tank-uk/buryak-pi-2021/docs/photos/FIX4.jpg

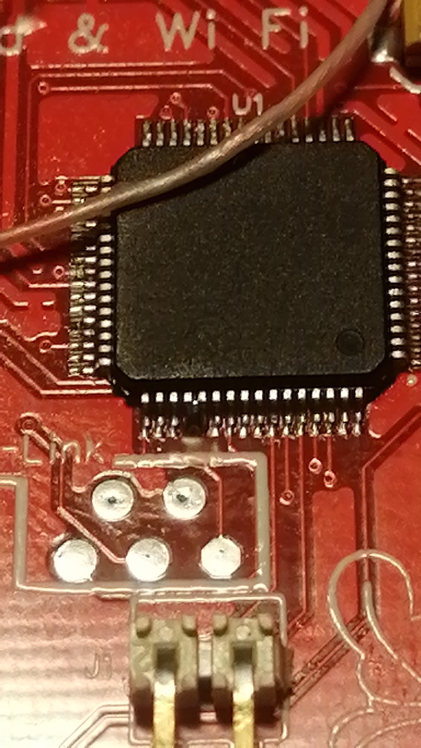
docs/photos/FIX4.jpg
