tank-uk/buryak-pi-2021/docs/photos/FIX3.jpg

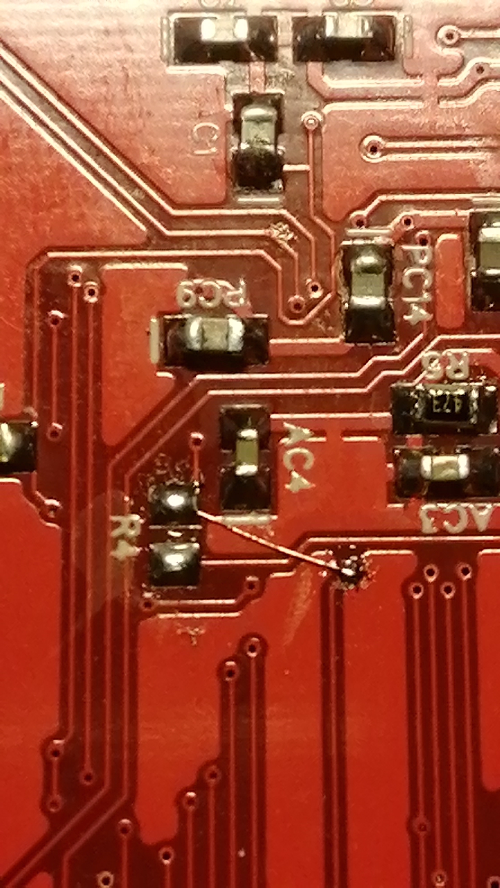
docs/photos/FIX3.jpg
