tank-uk/buryak-pi-2021/README.md

# buryak-pi-2021
FPGA based Buryak

  Центральный Процессор Z80 (Z84C0020FEC)
  
  Основная логика EP4CE6E22C8
  
  Память CY62167ELL(EV30/DV30)
  
  Контроллер Клавиатуры и Джойстика AtMega8a-16
  
  Выход VGA 50Hz
  
  Тайминги Пентагон

  2 турбо режима без вейта 7 и 14 МГц с индикацией светодиодом ( для ТЕСТИРОВАНИЯ Z80 и памяти есть прошивка 21МГЦ , только для тестов , многое не работает из-за рассинхронизации с периферией )
  
Периферия:

  DivMMC , Z-контроллер
  
  Tape IN/OUT
  
  WildSound III (STM32F405) ( AY , TS , XM ) с USB-UART ( CP2102 )
  
  SoundDrive
  
  Wi-Fi на порту AY
  
  Buryak 2021 управление:

F1-F8       - выбор ПЗУ ( индицируется светодиодом ) 0 банк не горит , все остальные - горит

F11         - NMI

F12         - Reset

Scroll Lock - Turbo ( индицируется светодиодом ) 3.5(не горит)/7(горит)/14(мигает)

Pause - пауза ( индицируется светодиодом )

Первая ошибка на плате звука , у микросхемы U7 (мост UART) нет соединения между 7 и 8 ножками
Вторая ошибка у компаратора U10 отсутствует подтяжка к питанию на выходе, нужно между 7 и 8 ножками U10 запаять резистор 1к 0603/0402

В герберах RC1.1 исправлено.

Добавлены герберы под китайский SD холдер
