tank-uk/buryak-pi-2021/docs/flashing.pdf

# Инструкция по прошивке

прошиваем AtMega8 этим :

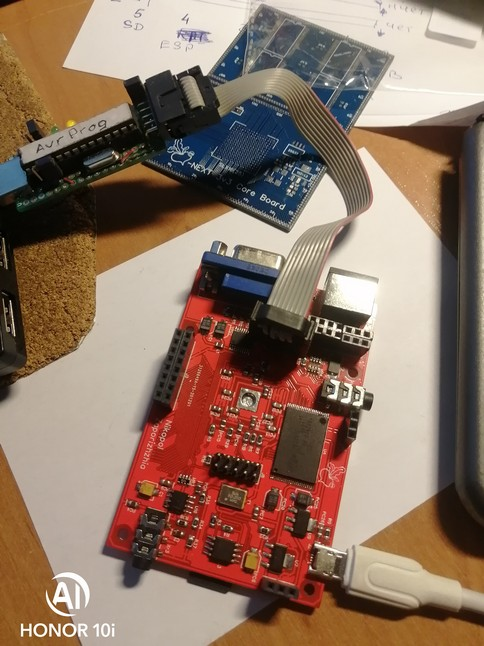
[picture p3: figure]

https://github.com/tank-uk/buryak-pi-2021/blob/main/firmware/release/avr_kbd.hex

### ФЬЮЗЫ : Low 8Eh, High: D9h

прошиваем FPGA ( Flash ) этим :

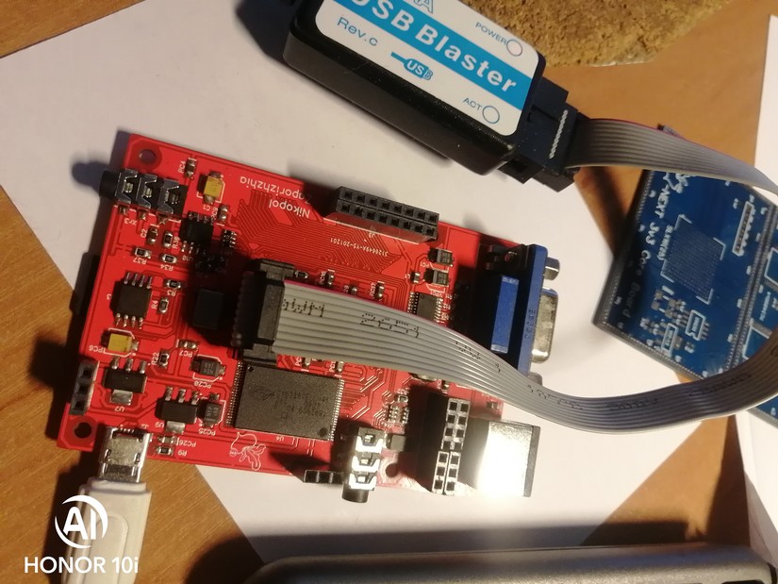
[picture p4: figure]

https://github.com/tank-uk/buryak-pi-2021/blob/main/firmware/release/firmware_speccy.jic

Для прошивки STM :

1. подключаем плату вертолетом

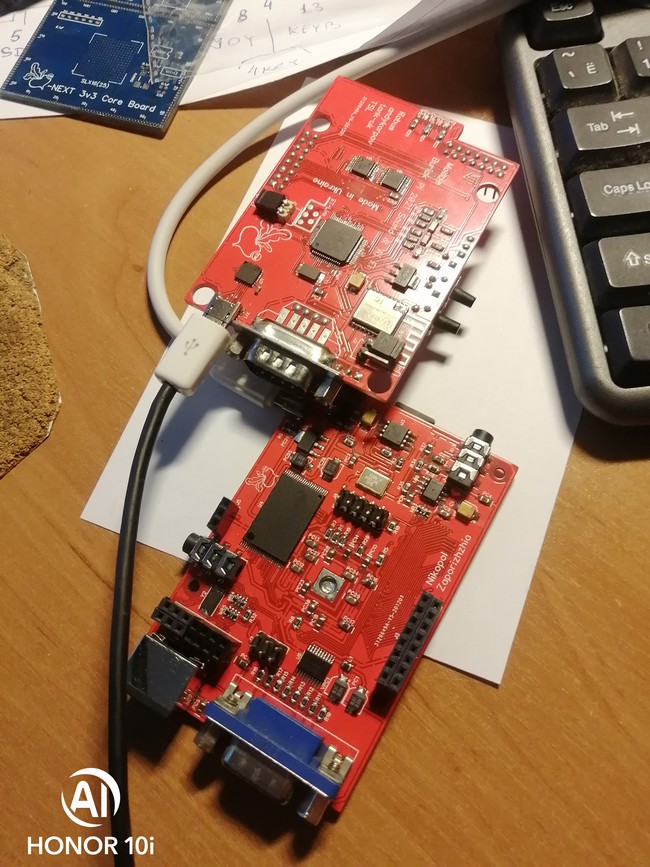
[picture p5: figure]

2. устанавливаем перемычку STM Boot

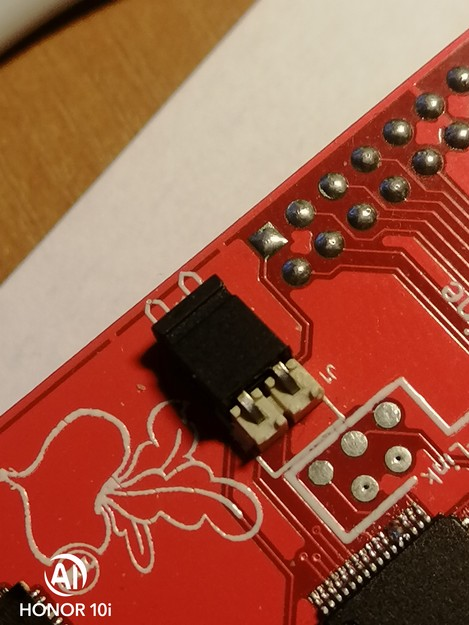
[picture p6: figure]

3. подаем питание на основную плату и вторым кабелем подключаем к ПК
4. проливаем это

https://github.com/tank-uk/buryak-pi-2021/blob/main/firmware/release/STM_AYX32_TSL_WILDSOUND_Final.hex (https://github.com/tank-uk/buryak-pi-2021/blob/main/firmware/release/STM_AYX32_TSL_WILDSOUND_Final.hex)

инструкция и софт по прошивке STM из Windows https://istarik.ru/blog/stm32/111.html

если при прошивке AtMega возникают ошибки:
разрезать перемычку AVR Power возле разьема AVR JTAG
подать питание на AVR от программатора
после прошивки залить перемычку припоем

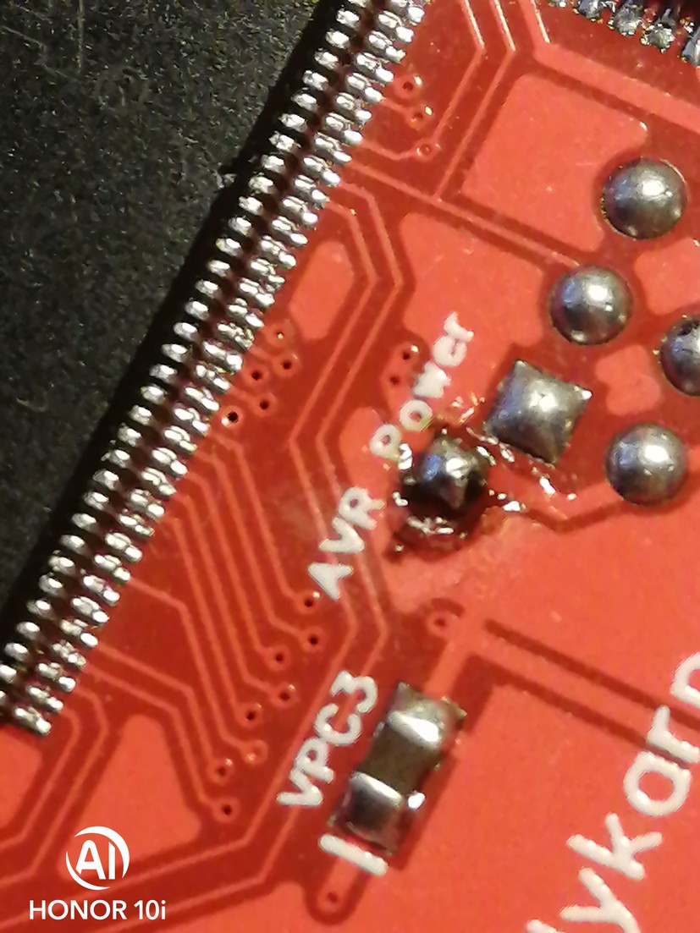
[picture p7: figure]
