tank-uk/buryak-pi-2021/docs/photos/Rev1_Fix1.png

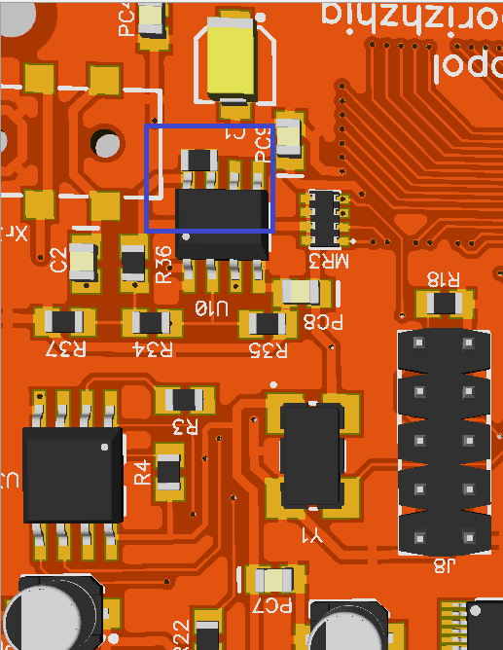
docs/photos/Rev1_Fix1.png
