tank-uk/buryak-pi-2021/docs/photos/Rev1_Fix2.png

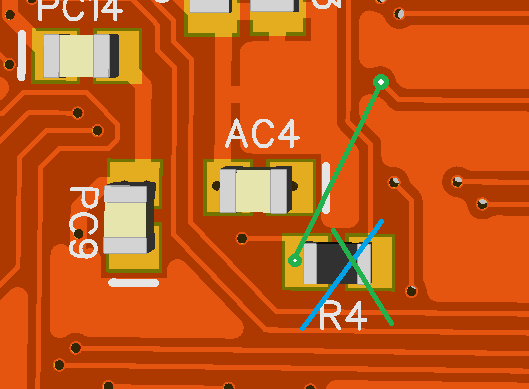
docs/photos/Rev1_Fix2.png
