tank-uk/buryak-pi-2021/docs/photos/Rev1_Fix4.png

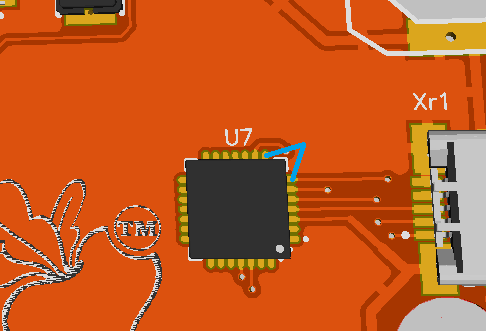
docs/photos/Rev1_Fix4.png
