tank-uk/buryak-pi-2021/(threads)

Thread 5 (2021-09-09):

Синхронизировать старт и начальный ресет от меги

andykarpov, 2021-09-09:
Сейчас мега ждет 2с и потом шлет сигнал сброса при старте.
В некоторых случаях почему-то это все не работает.
Нужно сделать как в карабасе, чтоб начальный сигнал сброса формировался, когда обе стороны готовы (fpga + avr).
