tank-uk/buryak-pi-2021/docs/CPU_Module.pdf

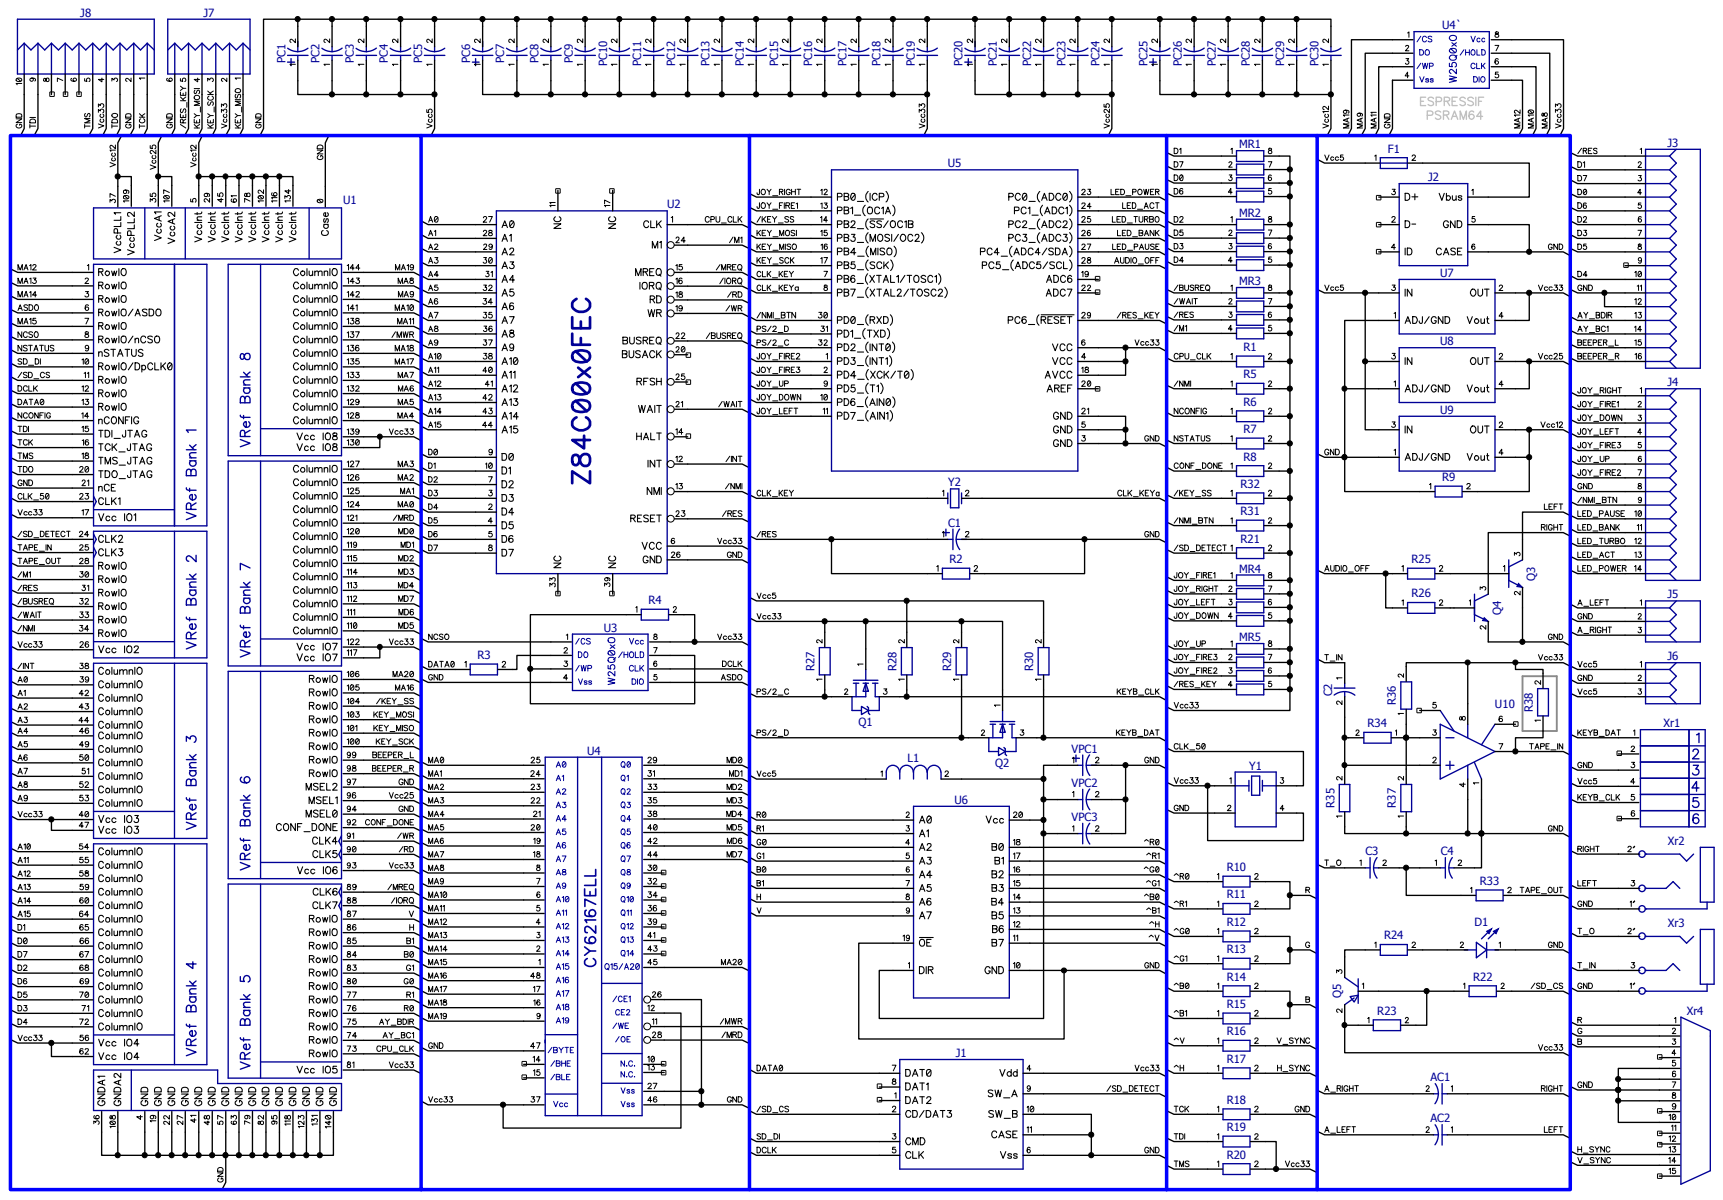
[picture p12: page 1]
