tank-uk/buryak-pi-2021/docs/Sound_WiFi.pdf

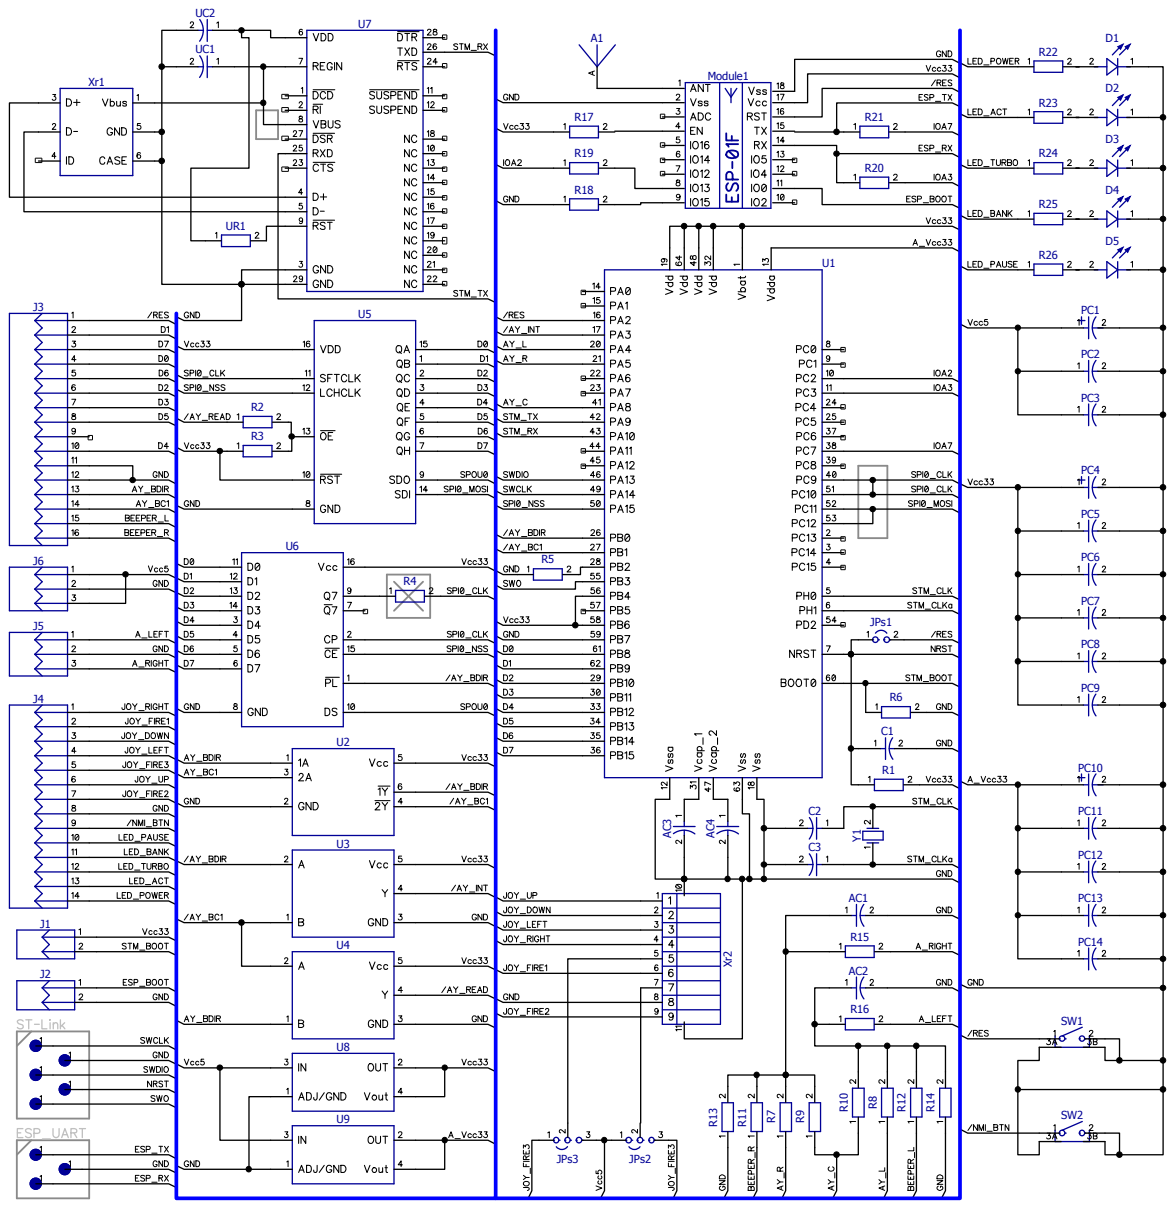
[picture p13: page 1]
