tank-uk/buryak-pi-2021/docs/Sound_WiFi_RC1.1.pdf

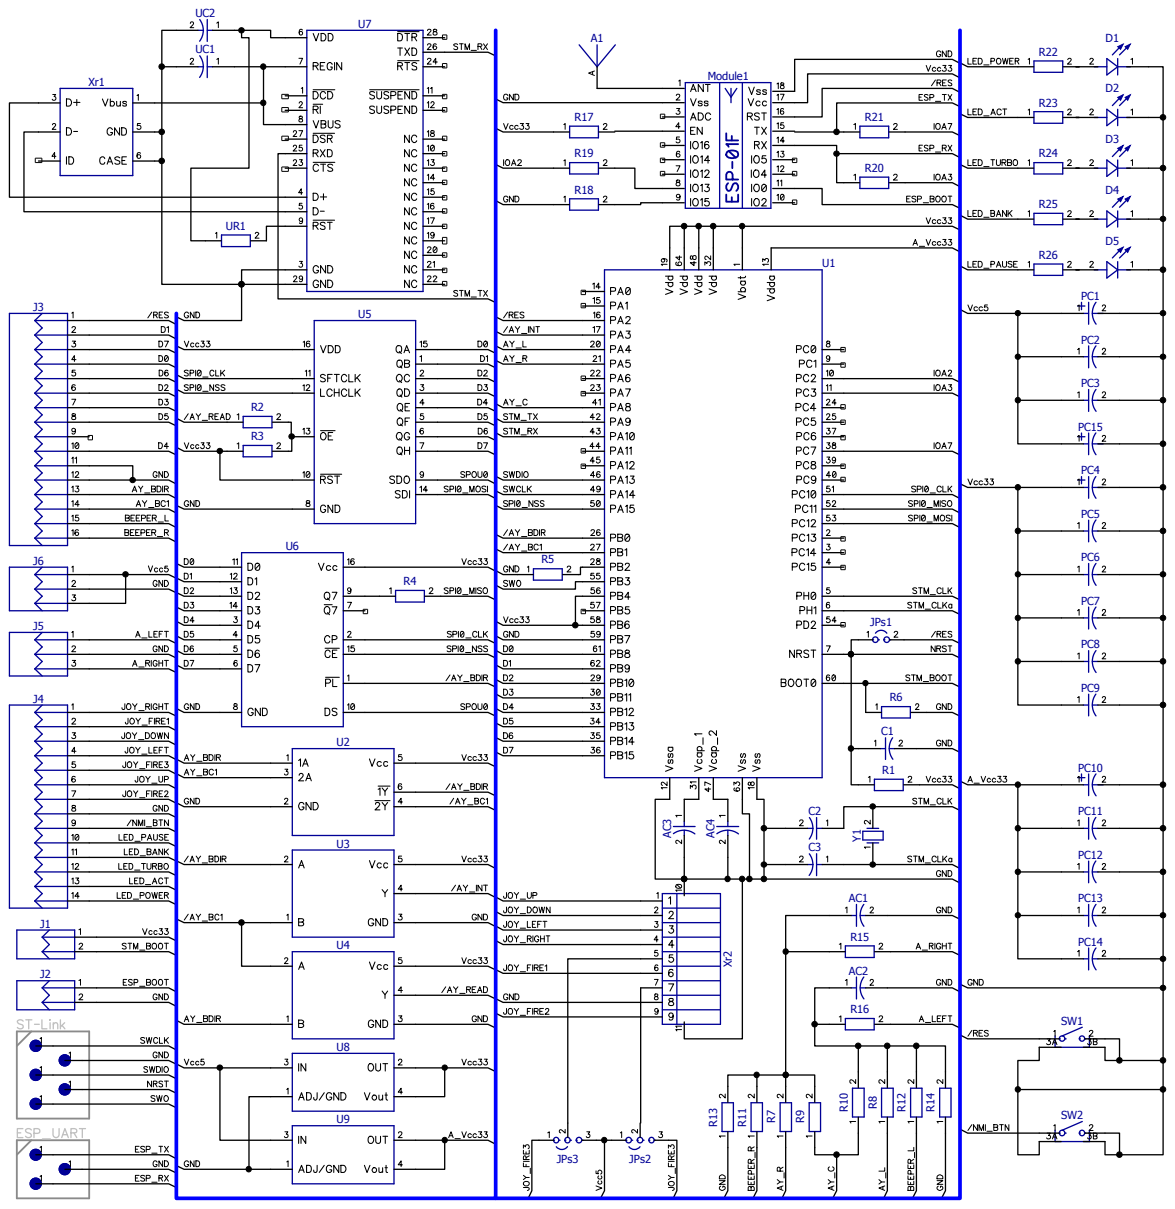
[picture p14: page 1]
