tank-uk/buryak-pi-2021/docs/CPU_bot_mont.pdf

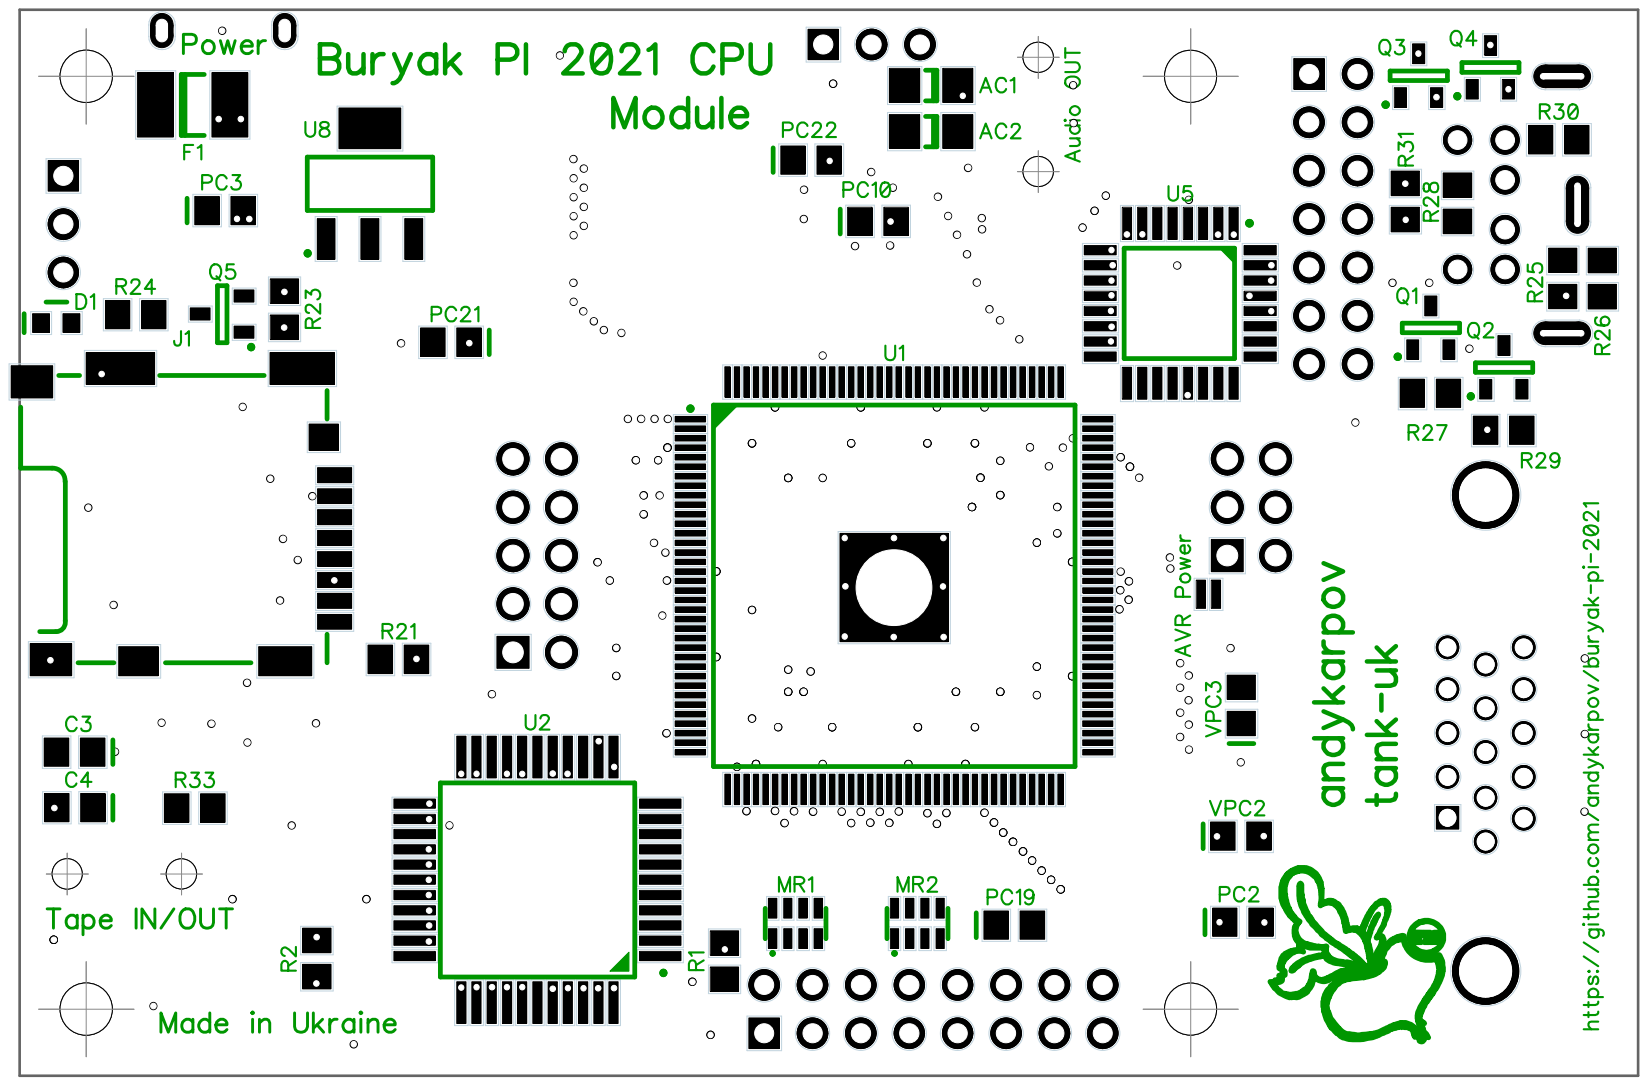
[picture p15: page 1]
