tank-uk/buryak-pi-2021/docs/CPU_top_mont.pdf

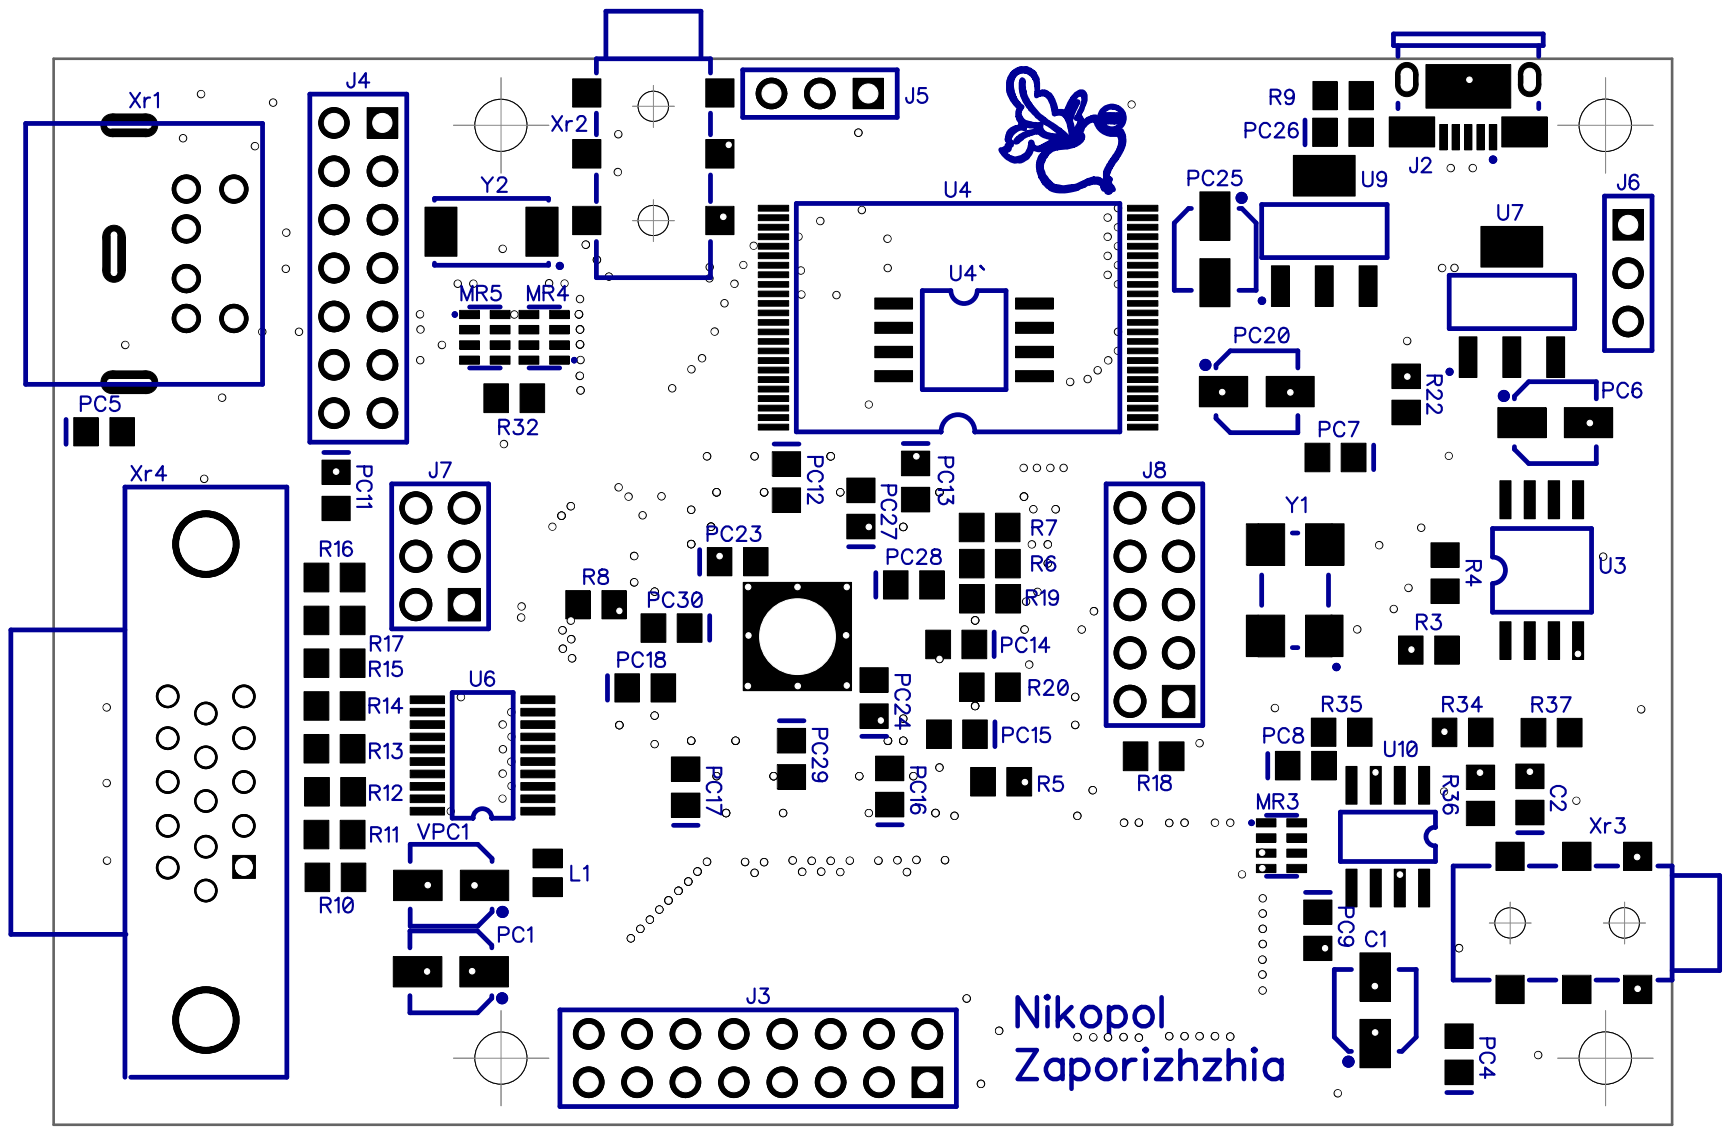
[picture p16: page 1]
