tank-uk/buryak-pi-2021/docs/Sound_WiFi_bot_mont.pdf

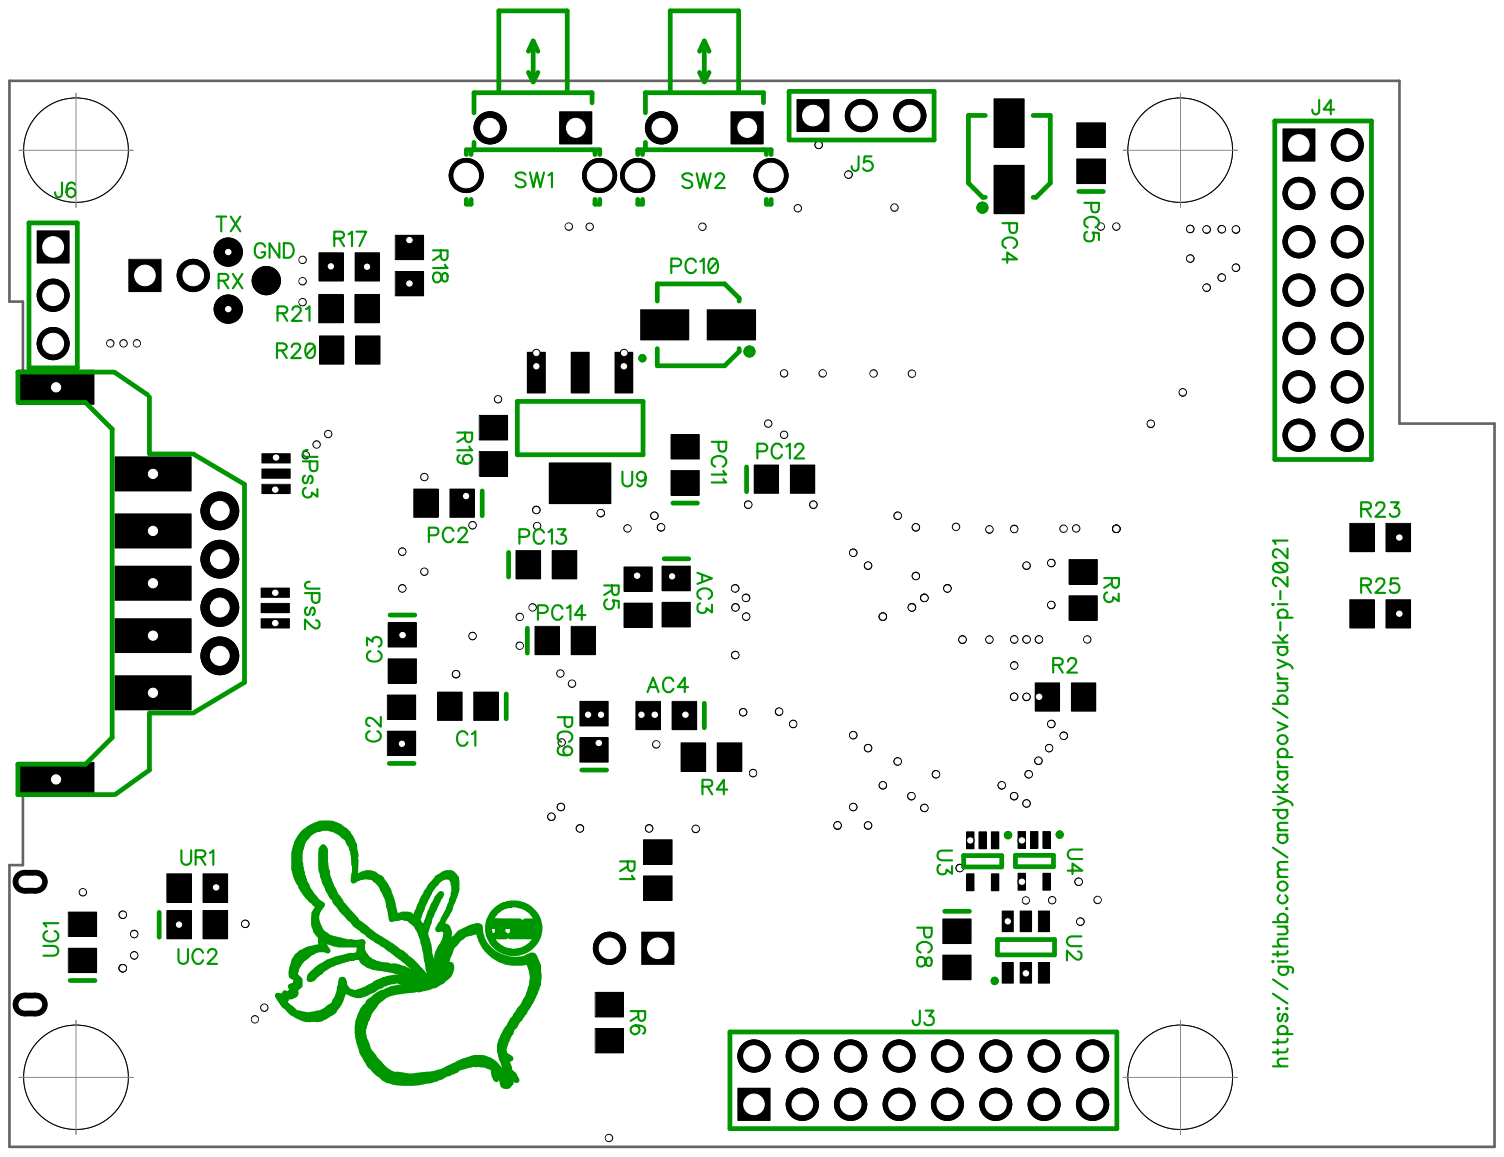
[picture p17: page 1]
