tank-uk/buryak-pi-2021/docs/Sound_WiFi_top_mont.pdf

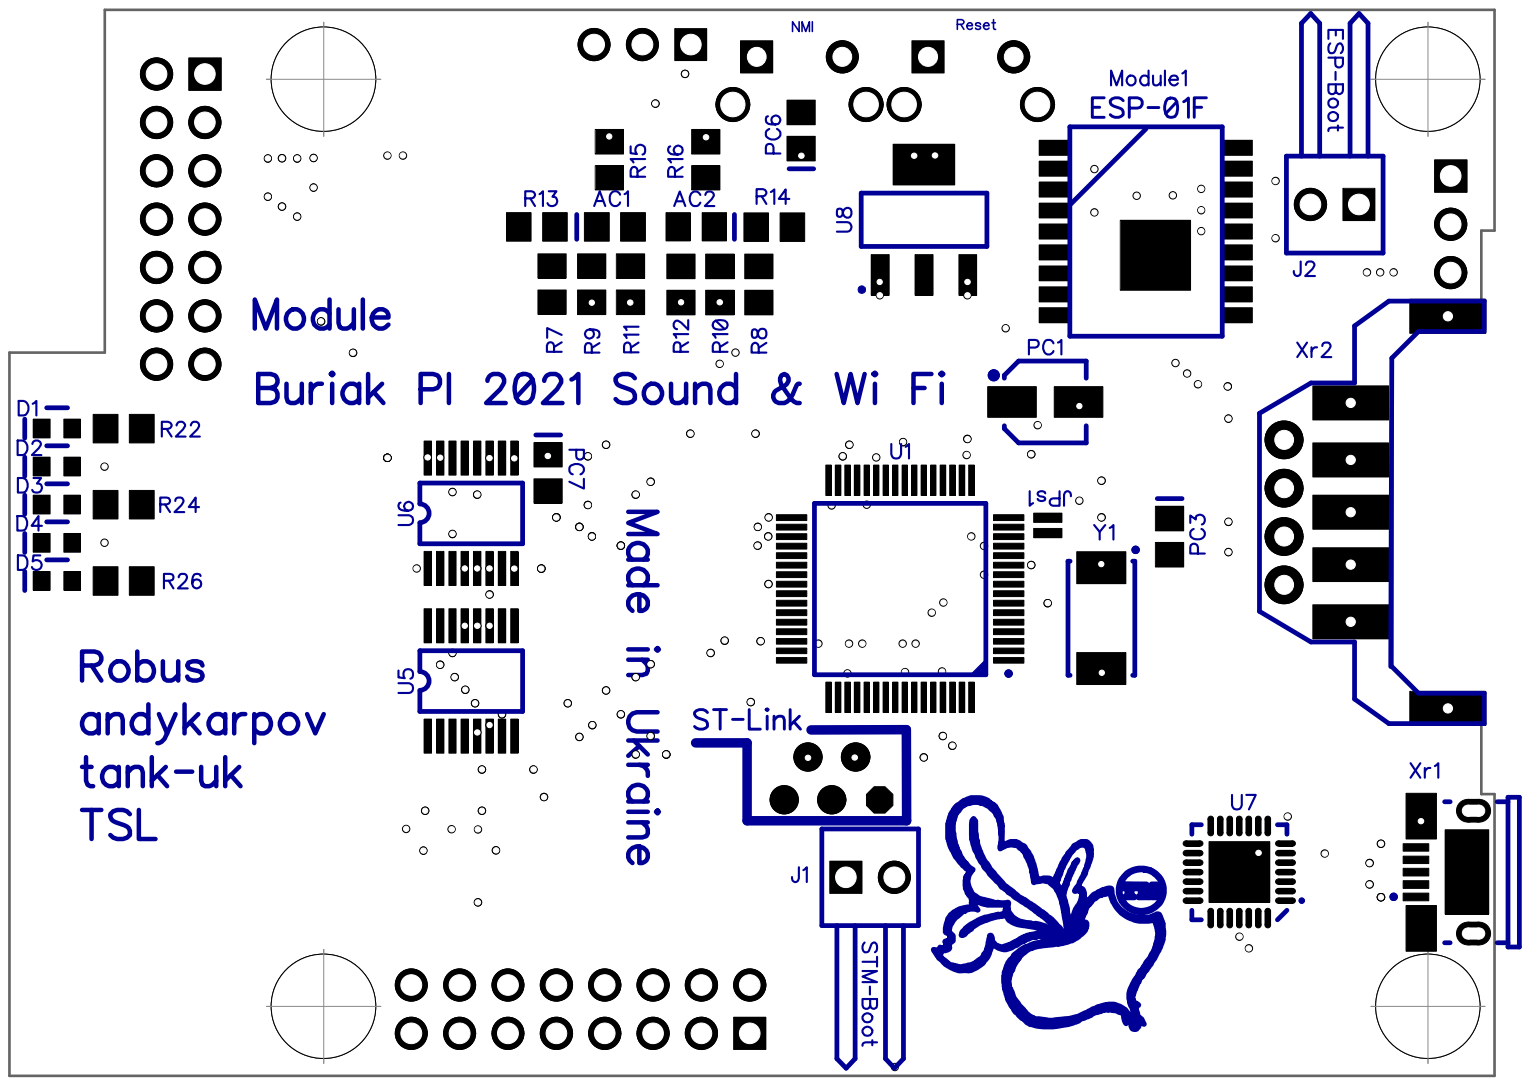
[picture p18: page 1]
