tank-uk/buryak-pi-2021/firmware/src/avr_kbd/sega_controller.cpp

//
// SegaController.cpp
//
// Author:
//       Jon Thysell <thysell@gmail.com>
//
// Copyright (c) 2017 Jon Thysell <http://jonthysell.com>
//
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
#include "Arduino.h"
#include "sega_controller.h"

SegaController::SegaController(byte db9_pin_7, byte db9_pin_1, byte db9_pin_2, byte db9_pin_3, byte db9_pin_4, byte db9_pin_6, byte db9_pin_9)
{
    // Set pins
    _selectPin = db9_pin_7;

    _inputPins[0] = db9_pin_1;
    _inputPins[1] = db9_pin_2;
    _inputPins[2] = db9_pin_3;
    _inputPins[3] = db9_pin_4;
    _inputPins[4] = db9_pin_6;
    _inputPins[5] = db9_pin_9;

    // Setup output pin
    pinMode(_selectPin, OUTPUT);
    digitalWrite(_selectPin, HIGH);

    // Setup input pins
    for (byte i = 0; i < SC_INPUT_PINS; i++)
    {
        pinMode(_inputPins[i], INPUT_PULLUP);
    }

    _currentState = 0;
    _sixButtonMode = false;
    _lastReadTime = millis();
}

word SegaController::getState()
{
    if (max(millis() - _lastReadTime, 0) < SC_READ_DELAY_MS)
    {
        // Not enough time has elapsed, return previously read state
        return _currentState;
    }
    
    noInterrupts();
    
    // Clear current state
    _currentState = 0;

    for (byte cycle = 0; cycle < SC_CYCLES; cycle++)
    {
        readCycle(cycle);
    }

    // When a controller disconnects, revert to three-button polling
    if (!(_currentState & SC_CTL_ON))
    {
        _sixButtonMode = false;
    }
    
    interrupts();
    
    _lastReadTime = millis();

    return _currentState;
}

void SegaController::readCycle(byte cycle)
{
    // Set the select pin low/high
    digitalWrite(_selectPin, cycle % 2);

    // Read flags
    switch (cycle)
    {
        case 2:
            // Check that a controller is connected
            _currentState |= (digitalRead(_inputPins[2]) == LOW && digitalRead(_inputPins[3]) == LOW) * SC_CTL_ON;
            
            // Check controller is connected before reading A/Start to prevent bad reads when inserting/removing cable
            if (_currentState & SC_CTL_ON)
            {
                // Read input pins for A, Start
                if (digitalRead(_inputPins[4]) == LOW) { _currentState |= SC_BTN_A; }
                if (digitalRead(_inputPins[5]) == LOW) { _currentState |= SC_BTN_START; }
            }
            break;
        case 3:
            // Read input pins for Up, Down, Left, Right, B, C
            if (digitalRead(_inputPins[0]) == LOW) { _currentState |= SC_BTN_UP; }
            if (digitalRead(_inputPins[1]) == LOW) { _currentState |= SC_BTN_DOWN; }
            if (digitalRead(_inputPins[2]) == LOW) { _currentState |= SC_BTN_LEFT; }
            if (digitalRead(_inputPins[3]) == LOW) { _currentState |= SC_BTN_RIGHT; }
            if (digitalRead(_inputPins[4]) == LOW) { _currentState |= SC_BTN_B; }
            if (digitalRead(_inputPins[5]) == LOW) { _currentState |= SC_BTN_C; }
            break;
        case 4:
            _sixButtonMode = (digitalRead(_inputPins[0]) == LOW && digitalRead(_inputPins[1]) == LOW);
            break;
        case 5:
            if (_sixButtonMode)
            {
                // Read input pins for X, Y, Z, Mode
                if (digitalRead(_inputPins[0]) == LOW) { _currentState |= SC_BTN_Z; }
                if (digitalRead(_inputPins[1]) == LOW) { _currentState |= SC_BTN_Y; }
                if (digitalRead(_inputPins[2]) == LOW) { _currentState |= SC_BTN_X; }
                if (digitalRead(_inputPins[3]) == LOW) { _currentState |= SC_BTN_MODE; }
            }
            break;
    }
}
