tank-uk/buryak-pi-2021/firmware/src/fpga/speccy/rtl/video/pentagon_video.vhd

-------------------------------------------------------------------------------
-- VIDEO Pentagon mode
-------------------------------------------------------------------------------

library IEEE; 
use IEEE.std_logic_1164.all; 
use IEEE.numeric_std.ALL;
use IEEE.std_logic_unsigned.all;

entity pentagon_video is
	port (
		CLK2X 	: in std_logic; -- 28 MHz
		CLK		: in std_logic; -- 14 MHz
		ENA		: in std_logic; -- 7 MHz 
		BORDER	: in std_logic_vector(2 downto 0);	-- bordr color (port #xxFE)
		DI			: in std_logic_vector(7 downto 0);	-- video data from memory
		TURBO 	: in std_logic_vector := "00"; -- turbo mode
		INTA		: in std_logic := '0'; -- int request for turbo mode
		INT		: out std_logic; -- int output
		MODE60	: in std_logic := '0'; -- '0'
		pFF_CS	: out std_logic; -- port FF select
		ATTR_O	: out std_logic_vector(7 downto 0); -- attribute register output
		A			: out std_logic_vector(13 downto 0); -- video address
		RGB		: out std_logic_vector(2 downto 0);	-- RGB
		I			: out std_logic; -- brightness
		HSYNC		: out std_logic;
		VSYNC		: out std_logic;
		HCNT 		: out std_logic_vector(9 downto 0);
		VCNT 		: out std_logic_vector(8 downto 0);	
		BLINK 	: out std_logic
	);
end entity;

architecture rtl of pentagon_video is

	signal invert   : unsigned(4 downto 0) := "00000";	-- Flash counter

	signal chr_col_cnt : unsigned(2 downto 0) := "000"; -- Character column counter
	signal chr_row_cnt : unsigned(2 downto 0) := "000"; -- Character row counter

	signal hor_cnt  : unsigned(5 downto 0) := "000000"; -- Horizontal char counter
	signal ver_cnt  : unsigned(5 downto 0) := "000000"; -- Vertical char counter
	
	signal attr     : std_logic_vector(7 downto 0);
	signal bitmap    : std_logic_vector(7 downto 0);
	
	signal paper_r  : std_logic;
	signal blank_r  : std_logic;
	signal attr_r   : std_logic_vector(7 downto 0);

	signal shift_r  : std_logic_vector(7 downto 0);
	signal shift_hr_r : std_logic_vector(15 downto 0);
	
	signal vid_reg : std_logic_vector(7 downto 0);

	signal paper     : std_logic;
	
	signal VIDEO_R 	: std_logic;
	signal VIDEO_G 	: std_logic;
	signal VIDEO_B 	: std_logic;
	signal VIDEO_I 	: std_logic;	
		
	signal int_sig : std_logic;
		
begin

	-- sync, counters
	process( CLK2X, CLK, ENA, chr_col_cnt, hor_cnt, chr_row_cnt, ver_cnt, TURBO, INTA)
	begin
		if CLK2X'event and CLK2X = '1' then
		
			if CLK = '1' and ENA = '1' then
			
				if chr_col_cnt = 7 then
				
					if hor_cnt = 55 then
						hor_cnt <= (others => '0');
					else
						hor_cnt <= hor_cnt + 1;
					end if;
					
					if hor_cnt = 39 then
						if chr_row_cnt = 7 then
							if (ver_cnt = 39 and MODE60 = '0') or (ver_cnt = 32 and MODE60 = '1')then
								ver_cnt <= (others => '0');
								invert <= invert + 1;
							else
								ver_cnt <= ver_cnt + 1;
							end if;
						end if;
						chr_row_cnt <= chr_row_cnt + 1;
					end if;
				end if;

				-- h/v sync

				if chr_col_cnt = 7 then

					if (hor_cnt(5 downto 2) = "1010") then 
						HSYNC <= '0';
					else 
						HSYNC <= '1';
					end if;
					
					if (ver_cnt /= 31 and MODE60 = '0') or (ver_cnt /= 27 and MODE60 = '1') then
						VSYNC <= '1';
					elsif chr_row_cnt = 3 or chr_row_cnt = 4 or ( chr_row_cnt = 5 and ( hor_cnt >= 40 or hor_cnt < 12 ) ) then
						VSYNC<= '0';
					else 
						VSYNC <= '1';
					end if;
					
--					if hor_cnt & chr_col_cnt = 327 and ver_cnt & chr_row_cnt = 240 then	-- works, but unstable :(
--						int_sig <= '0';
--					elsif INTA = '0' then
--						int_sig <= '1';
--					end if;
					
				end if;
			
				-- int
				if TURBO /= "00" then
					-- TURBO int
					if hor_cnt & chr_col_cnt = 318 and ver_cnt & chr_row_cnt = 239 then
						int_sig <= '0';
					elsif INTA = '0' then
						int_sig <= '1';
					end if;
				else 
					-- PENTAGON int
					if chr_col_cnt = 6 and hor_cnt(2 downto 0) = "111" then
						if ver_cnt = 29 and chr_row_cnt = 7 and hor_cnt(5 downto 3) = "100" then
							int_sig <= '0';
						else
							int_sig <= '1';
						end if;
					end if;

				end if;

				chr_col_cnt <= chr_col_cnt + 1;
			end if;
		end if;
	end process;

	-- r/g/b/i
	process( CLK2X, CLK, paper_r, shift_r, attr_r, invert, blank_r, BORDER )
	begin
		if CLK2X'event and CLK2X = '1' then
		if CLK = '1' and ENA = '1' then
			if paper_r = '0' then -- paper
					-- standard RGB
					if( shift_r(7) xor ( attr_r(7) and invert(4) ) ) = '1' then -- fg pixel
						VIDEO_B <= attr_r(0);
						VIDEO_R <= attr_r(1);
						VIDEO_G <= attr_r(2);
					else	-- bg pixel
						VIDEO_B <= attr_r(3);
						VIDEO_R <= attr_r(4);
						VIDEO_G <= attr_r(5);
					end if;
					VIDEO_I <= attr_r(6);
			else -- not paper
				if blank_r = '0' then
					-- blank
					VIDEO_B <= '0';
					VIDEO_R <= '0';
					VIDEO_G <= '0';
					VIDEO_I <= '0';
				else -- std border
					-- standard RGB
					VIDEO_B <= BORDER(0);
					VIDEO_R <= BORDER(1);
					VIDEO_G <= BORDER(2);
					VIDEO_I <= '0';
				end if;
			end if;
		end if;
		end if;
	end process;

	-- paper, blank
	process( CLK2X, CLK, ENA, chr_col_cnt, hor_cnt, ver_cnt, shift_hr_r, attr, bitmap, paper, shift_r )
	begin
		if CLK2X'event and CLK2X = '1' then
			if CLK = '1' then		
				if ENA = '1' then
					if chr_col_cnt = 7 then
						if ((hor_cnt(5 downto 0) > 38 and hor_cnt(5 downto 0) < 48) or ((ver_cnt(5 downto 1) = 15 and MODE60 = '0') or (ver_cnt(5 downto 1) = 14 and MODE60 = '1'))) then	-- 15 = for 320 lines, 13 = for 264 lines
							blank_r <= '0';
						else 
							blank_r <= '1';
						end if;							
						paper_r <= paper;
					end if;
				end if;
			end if;
		end if;
	end process;	
	
	-- bitmap shift registers
	process( CLK2X, CLK, ENA, chr_col_cnt, hor_cnt, ver_cnt, shift_hr_r, attr, bitmap, paper, shift_r )
	begin
		if CLK2X'event and CLK2X = '1' then

			if CLK = '1' then
					-- standard shift register 
					if ENA = '1' then
						if chr_col_cnt = 7 then
							attr_r <= attr;
							shift_r <= bitmap;
						else
							shift_r(7 downto 1) <= shift_r(6 downto 0);
							shift_r(0) <= '0';
						end if;
					end if;
			end if;
		end if;
	end process;
	
	-- video mem read cycle
	process (CLK2X, CLK, chr_col_cnt, vid_reg)
	begin 
		if CLK2X'event and CLK2X = '1' then 
			if CLK = '1' then
				if ENA = '0' then
					case chr_col_cnt(2 downto 0) is 
						when "100" => A <= std_logic_vector( '0' & ver_cnt(4 downto 3) & chr_row_cnt & ver_cnt(2 downto 0) & hor_cnt(4 downto 0));
						when "101" => vid_reg <= DI;
						when "110" => A <= std_logic_vector( '0' & "110" & ver_cnt(4 downto 0) & hor_cnt(4 downto 0));
						when "111" => 
							bitmap <= vid_reg;
							attr <= DI;
						when others => null;
					end case;
				end if;
			end if;
		end if;
	end process;
	
	paper <= '0' when hor_cnt(5) = '0' and ver_cnt(5) = '0' and ( ver_cnt(4) = '0' or ver_cnt(3) = '0' ) else '1';
	
	RGB <= VIDEO_R & VIDEO_G & VIDEO_B;
	I <= VIDEO_I;
	pFF_CS	<= not paper;
	ATTR_O	<= attr_r;

	INT <= int_sig;
	
	HCNT <= '0' & std_logic_vector(hor_cnt) & std_logic_vector(chr_col_cnt);
	VCNT <= std_logic_vector(ver_cnt) & std_logic_vector(chr_row_cnt);

	BLINK <= invert(4);

end architecture;
