tank-uk/buryak-pi-2021/firmware/src/fpga/speccy/rtl/video/scan_convert.vhd

--	(c) 2012 d18c7db(a)hotmail
--
--	This program is free software; you can redistribute it and/or modify it under
--	the terms of the GNU General Public License version 3 or, at your option,
--	any later version as published by the Free Software Foundation.
--
--	This program is distributed in the hope that it will be useful,
--	but WITHOUT ANY WARRANTY; without even the implied warranty of
--	MERCHANTABILITY or FITNESS FOR A PARTICULAR PURPOSE.
--
-- For full details, see the GNU General Public License at www.gnu.org/licenses

--------------------------------------------------------------------------------
-- Video scan converter
--
--	Horizonal Timing
-- _____________              ______________________              _____________________
-- VIDEO (last) |____________|         VIDEO        |____________|         VIDEO (next)
-- -hD----------|-hA-|hB|-hC-|----------hD----------|-hA-|hB|-hC-|----------hD---------
-- __________________|  |________________________________|  |__________________________
-- HSYNC             |__|              HSYNC             |__|              HSYNC

-- Vertical Timing
-- _____________              ______________________              _____________________
-- VIDEO (last)||____________||||||||||VIDEO|||||||||____________||||||||||VIDEO (next)
-- -vD----------|-vA-|vB|-vC-|----------vD----------|-vA-|vB|-vC-|----------vD---------
-- __________________|  |________________________________|  |__________________________
-- VSYNC             |__|              VSYNC             |__|              VSYNC

-- Scan converter input and output timings compared to standard VGA
--	Resolution  - Frame   | Pixel      | Front     | HSYNC      | Back       | Active      | HSYNC    | Front    | VSYNC    | Back     | Active    | VSYNC
--              - Rate    | Clock      | Porch hA  | Pulse hB   | Porch hC   | Video hD    | Polarity | Porch vA | Pulse vB | Porch vC | Video vD  | Polarity
-------------------------------------------------------------------------------------------------------------------------------------------------------------
--  In  256x224 - 59.18Hz |  6.000 MHz | 38 pixels |  32 pixels |  58 pixels |  256 pixels | negative | 16 lines | 8 lines  | 16 lines | 224 lines | negative
--  Out 640x480 - 59.18Hz | 24.000 MHz |  2 pixels |  92 pixels |  34 pixels |  640 pixels | negative | 17 lines | 2 lines  | 29 lines | 480 lines | negative
--  VGA 640x480 - 59.94Hz | 25.175 MHz | 16 pixels |  96 pixels |  48 pixels |  640 pixels | negative | 10 lines | 2 lines  | 33 lines | 480 lines | negative

library ieee;
	use ieee.std_logic_1164.all;
	use ieee.std_logic_unsigned.all;
	use ieee.numeric_std.all;

entity scan_convert is
	generic (
		cstart		: integer range 0 to 1023 := 32*2;	-- composite sync start --38 46
		clength		: integer range 0 to 1023 := 384*2;	-- composite sync length

		hA				: integer range 0 to 1023 :=  12*2;	-- h front porch
		hB				: integer range 0 to 1023 :=  32*2;	-- h sync
		hC				: integer range 0 to 1023 :=  20*2;	-- h back porch
		hD				: integer range 0 to 1023 := 384*2;	-- visible video

--		vA				: integer range 0 to 1023 :=  16;	-- v front porch
		vB				: integer range 0 to 1023 :=   2;	-- v sync
		vC				: integer range 0 to 1023 :=  4;	-- v back porch 10
		vD				: integer range 0 to 1023 := 304;	-- visible video 284 304 288

		hpad			: integer range 0 to 1023 :=   0;	-- H black border
		vpad			: integer range 0 to 1023 :=   0		-- V black border
	);
	port (
		I_VIDEO				: in  std_logic_vector(3 downto 0);
		I_HSYNC				: in  std_logic;
		I_VSYNC				: in  std_logic;
		--
		O_RED					: out std_logic_vector(1 downto 0);
		O_GREEN					: out std_logic_vector(1 downto 0);
		O_BLUE					: out std_logic_vector(1 downto 0);

		O_HSYNC				: out std_logic;
		O_VSYNC				: out std_logic;
		O_CMPBLK_N			: out std_logic;
		--
		CLK					: in  std_logic;
		CLK_x2				: in  std_logic
	);
end;

architecture RTL of scan_convert is
	--
	-- input timing
	--
	signal ivsync_last_x2	: std_logic := '1';
	signal ihsync_last		: std_logic := '1';
	signal hpos_i			: std_logic_vector( 9 downto 0) := (others => '0');

	--
	-- output timing
	--
	signal hpos_o			: std_logic_vector(9 downto 0) := (others => '0');

	signal vcnt				: integer range 0 to 1023 := 0;
	signal hcnt				: integer range 0 to 1023 := 0;
	signal hcnti			: integer range 0 to 1023 := 0;
	
	signal blank 			: std_logic;
	
	signal WR_REG 			: std_logic_vector(7 downto 0);
	signal RD_REG 			: std_logic_vector(7 downto 0);
	
	signal rgbi				: std_logic_vector(3 downto 0);

begin

	LINEBUF: entity work.linebuf
	port map (
		address_a => hpos_i,
		clock_a 	 => CLK_x2 and CLK,
		data_a 	 => WR_REG,
		wren_a 	 => '1',
		q_a 		 => open,
		
		address_b => hpos_o,
		clock_b 	 => not(CLK_x2 and CLK),
		data_b 	 => (others => '1'),
		wren_b 	 => '0',
		q_b 		 => RD_REG
	);

	process (CLK_x2, CLK, hpos_i) 
	begin 
		if rising_edge(CLK_x2) then
			if (CLK = '1') then
				if (hpos_i(0) = '0') then
					WR_REG(3 downto 0) <= I_VIDEO;
				else
					WR_REG(7 downto 4) <= I_VIDEO;
				end if;
			end if;
		end if;
	end process;
	
	process (CLK_x2)
	begin 
		if (falling_edge(CLK_x2)) then 
			if (CLK = '0') then 
				rgbi <= RD_REG(3 downto 0);
			else
				rgbi <= RD_REG(7 downto 4);
			end if;
		end if;
	end process;
	
--	process (CLK_x2)
--	begin
--		if (rising_edge(CLK_x2)) then 
--			
--			if (blank = '0') then 
--				O_RED <= "00";
--				O_GREEN <= "00";
--				O_BLUE <= "00";
--			else				
--				O_RED(1) <= rgbi(3);
--				O_GREEN(1) <= rgbi(2);
--				O_BLUE(1) <= rgbi(1);
--
--				if (rgbi(0) = '0') then 
--					O_RED(0) <= '0';
--					O_GREEN(0) <= '0';
--					O_BLUE(0) <= '0';
--				else
--					O_RED(0) <= 'Z';
--					O_GREEN(0) <= 'Z';
--					O_BLUE(0) <= 'Z';
--				end if;
--			end if;
--		end if;	
--	end process;
	
	U6BIT: entity work.rgbi_6bit
	port map (
		I_CLK   => CLK_x2,
		I_BLANK => not blank,
		I_RED	  => rgbi(3),
		I_GREEN => rgbi(2),
		I_BLUE  => rgbi(1),
		I_BRIGHT => rgbi(0),
		O_RGB(5 downto 4) => O_RED,
		O_RGB(3 downto 2) => O_GREEN,
		O_RGB(1 downto 0) => O_BLUE
	);
	
	-- horizontal counter for input video
	p_hcounter : process (CLK, I_HSYNC, ihsync_last, hcnti)
	begin
		if CLK'event and CLK = '0' then
			ihsync_last <= I_HSYNC;
			-- trigger off rising hsync
			if I_HSYNC = '1' and ihsync_last = '0' then
				hcnti <= 0;
			else
				hcnti <= hcnti + 1;
			end if;
		end if;
	end process;

	-- increment write position during active video
	p_ram_in : process (CLK, hcnti)
	begin
		if (CLK'event and CLK = '0') then
			if (hcnti < cstart) or (hcnti >= (cstart + clength)) then
				hpos_i <= (others => '0');
			else
				hpos_i <= hpos_i + 1;
			end if;
		end if;
	end process;

	-- VGA H and V counters, synchronized to input frame V sync, then H sync
	p_out_ctrs : process (CLK_x2, I_VSYNC, ivsync_last_x2, hcnt)
		variable trigger : boolean;
	begin
		if CLK_x2'event and CLK_x2 = '1' then
			ivsync_last_x2 <= I_VSYNC;
			if (I_VSYNC = '0') and (ivsync_last_x2 = '1') then
				trigger := true;
			elsif trigger and I_HSYNC = '0' then
				trigger := false;
				hcnt <= 0;
				vcnt <= 0;
			else
				hcnt <= hcnt + 1;
				if hcnt = (hA+hB+hC+hD+hpad+hpad-1) then
					hcnt <= 0;
					vcnt <= vcnt + 1;
				end if;
			end if;
		end if;
	end process;
	
	-- generate hsync
	p_gen_hsync : process (CLK_x2)
	begin
		if CLK_x2'event and CLK_x2 = '1' then
		-- H sync timing
			if (hcnt < hB) then
				O_HSYNC <= '0';
			else
				O_HSYNC <= '1';
			end if;
		end if;
	end process;

	-- generate vsync
	p_gen_vsync : process (CLK_x2)
	begin
		if CLK_x2'event and CLK_x2 = '1' then
		-- V sync timing
			if (vcnt < vB) then
				O_VSYNC <= '0';
			else
				O_VSYNC <= '1';
			end if;
		end if;
	end process;

	-- generate active output video
	p_gen_active_vid : process (CLK_x2)
	begin
		if CLK_x2'event and CLK_x2 = '1' then
			-- visible video area doubled from the original game
			if ((hcnt >= (hB + hC + hpad)) and (hcnt < (hB + hC + hD + hpad))) and ((vcnt > 2*(vB + vC + vpad)) and (vcnt <= 2*(vB + vC + vD + vpad))) then
				hpos_o <= hpos_o + 1;
			else
				hpos_o <= (others => '0');
			end if;
		end if;
	end process;
	
	-- generate blanking signal including additional borders to pad the input signal to standard VGA resolution
	p_gen_blank : process (CLK_x2)
	begin
		if CLK_x2'event and CLK_x2 = '1' then
			-- active video area 640x480 (VGA) after padding with blank borders
			if ((hcnt >= (hB + hC)) and (hcnt < (hB + hC + hD + 2*hpad))) and ((vcnt > 2*(vB + vC)) and (vcnt <= 2*(vB + vC + vD + 2*vpad))) then
				blank <= '1';
			else
				blank <= '0';
			end if;
		end if;
	end process;
	
end architecture RTL;
