tank-uk/buryak-pi-2021/(commit log)

2020-12-16 Moved arduino project to platformio
2020-12-22 fixed nmi hw button
    [main.cpp]
2021-01-02 Add files via upload
    3D модель
2021-01-09 Added rombanks + hw switch
2021-01-11 Новый билд под AVR с кнопкой Pause для WAITов и переделки из Karabas-Pro для кнопок нажатых с CS
2021-01-11 Убраны лишние старые прошивки AYX
2021-03-13 Added turbo switch 3.5 - 7 - 14
2021-03-13 Подмешан tape in / tape out в вывод
2021-03-13 сборка с подмешанным tape in /tape out
2021-03-13 отключен (по флажку) встроенный turbosound
2021-03-13 выключен встроенный turbosound
2021-03-13 тактирование ZX от клока проца
2021-04-06 Added an additional fire buttons processing from sega joy
2021-04-14 Fixed SEGA joy release - disabled interrupts/nointerrupts calls
2021-09-10 Init reset with space
    [main.cpp]
2021-09-10 DivMMC reset only on AVR reset
    [firmware_top.vhd]
