tank-uk/buryak-pi-2021/(notices)

Notices in the files:
firmware/src/fpga/speccy/rtl/memory/llqspi.v:
General Public License as published by the Free Software Foundation, either
License: LGPL, v3, as defined and found on www.gnu.org,
http://www.gnu.org/licenses/lgpl.html
